shawnduong/badger/docs/README.md

# Documentation

A knowledge base for partners and developers is available publicly on [Notion](https://shawnduong.notion.site/Badger-f6cf24df8de64274823ae53d65968d2a?pvs=73).

This directory contains in-depth, technical documentation about Badger.
