shawnduong/badger/schematics/b1/b1.kicad_pcb

## KiCad design schematics/b1/b1.kicad_pcb (2024-02-21)

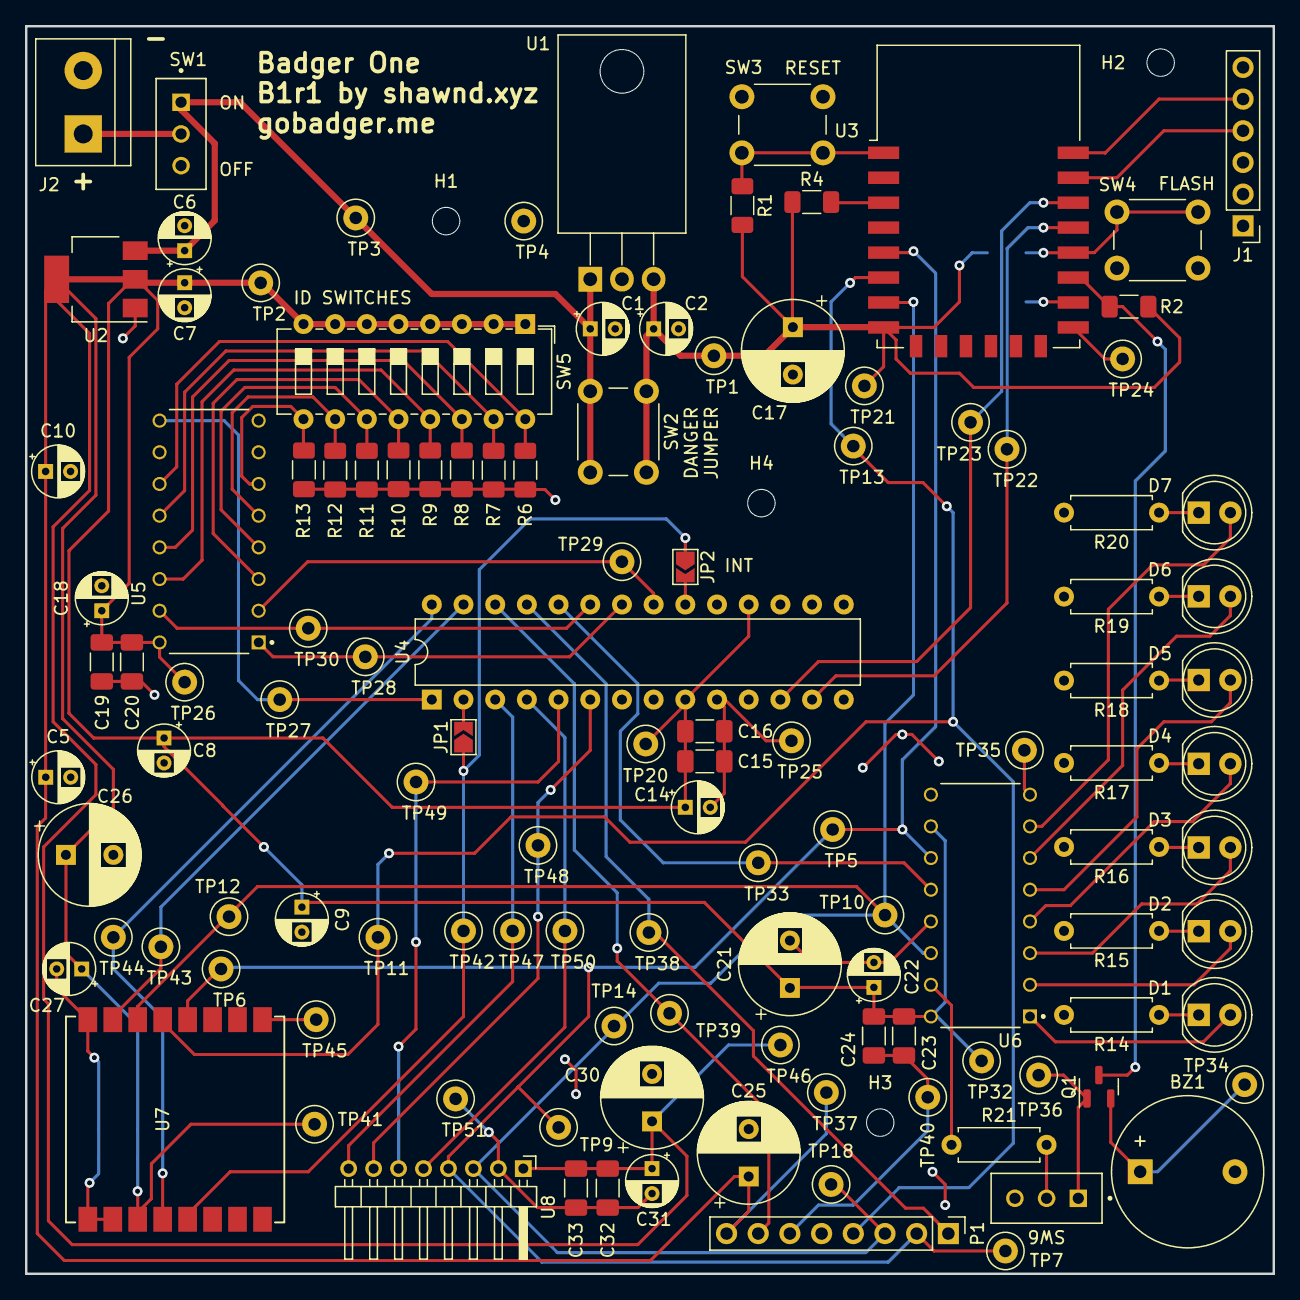
[picture p1: board b1.kicad_pcb from above]

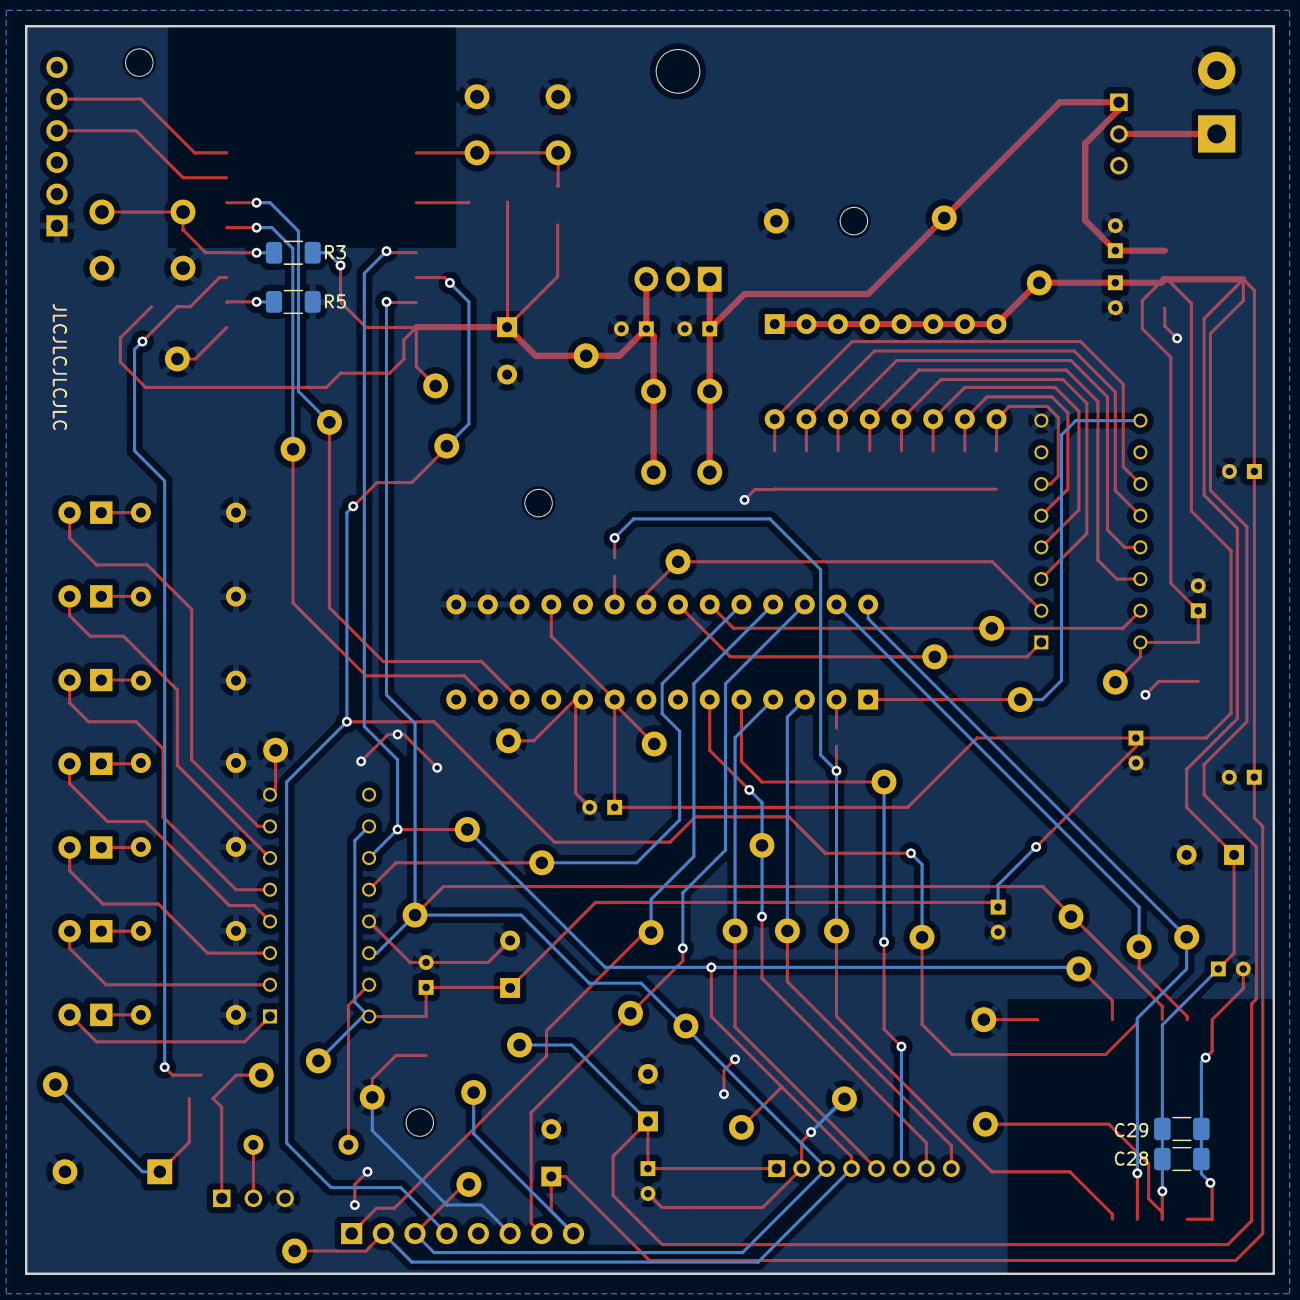
[picture p2: board b1.kicad_pcb from below]

Board: 2 copper layers, 100.0 x 100.0 mm, 126 parts (4 on the bottom side), 59 nets.

Parts:
BZ1: Buzzer; Buzzer_12x9.5RM7.6
C1, C2, C6, C7, C14, C18, C22, C27, C31: 10u; CP_Radial_D4.0mm_P2.00mm
C5, C8, C9, C10: C; CP_Radial_D4.0mm_P2.00mm
C15, C19, C23, C28, C32: 1u; C_1206_3216Metric_Pad1.33x1.80mm_HandSolder
C16, C20, C24, C29, C33: 0.1u; C_1206_3216Metric_Pad1.33x1.80mm_HandSolder
C17, C25, C26: 1m; CP_Radial_D8.0mm_P3.80mm
C21, C30: 470u; CP_Radial_D8.0mm_P3.80mm
D1: WHITE; LED_D5.0mm
D2, D7: YELLOW; LED_D5.0mm
D3: GREEN; LED_D5.0mm
D4, D6: RED; LED_D5.0mm
D5: BLUE; LED_D5.0mm
H1, H2, H3, H4: MountingHole; MountingHole_2.2mm_M2
J1: SERIAL; PinHeader_1x06_P2.54mm_Vertical
J2: POWER; TerminalBlock_bornier-2_P5.08mm
JP1, JP2: SolderJumper_2_Open; SolderJumper-2_P1.3mm_Open_TrianglePad1.0x1.5mm
P1: RFID-RC522; PinHeader_1x08_P2.54mm_Vertical
Q1: MMBT3904; SOT-23
R1, R2, R3, R4, R5, R6, R7, R8, R9, R10, R11, R12, R13: 10k; R_1206_3216Metric_Pad1.30x1.75mm_HandSolder
R14, R15, R16, R17, R18, R19, R20: 360; R_Axial_DIN0207_L6.3mm_D2.5mm_P7.62mm_Horizontal
R21: 47; R_Axial_DIN0207_L6.3mm_D2.5mm_P7.62mm_Horizontal
SW1: PWR_SW; SW_SPDT
SW2: JUMP; SW_PUSH_6mm_H4.3mm
SW3: RESET; SW_PUSH_6mm_H4.3mm
SW4: FLASH; SW_PUSH_6mm_H4.3mm
SW5: SW_DIP_x08; SW_DIP_SPSTx08_Slide_6.7x21.88mm_W7.62mm_P2.54mm_LowProfile
SW6: SW_SPDT
TP1, TP2, TP3, TP4, TP5, TP6, TP7, TP9, TP10, TP11, TP12, TP13, TP14, TP18, TP20, TP21, TP22, TP23, TP24, TP25, TP26, TP27, TP28, TP29, TP30, TP32, TP33, TP34, TP35, TP36, TP37, TP38, TP39, TP40, TP41, TP42, TP43, TP44, TP45, TP46, TP47, TP48, TP49, TP50, TP51: TestPoint; TestPoint_Loop_D2.50mm_Drill1.0mm
U1: L7805; TO-220-3_Horizontal_TabDown
U2: AMS1117-3.3; SOT-223-3_TabPin2
U3: ESP-12F; ESP-12E
U4: MCP23017_SP; DIP-28_W7.62mm
U5: 74HC165; DIP794W45P254L1969H508Q16
U6: 74HC595; DIP794W45P254L1969H508Q16
U7: Ai-Thinker-Ra-02; Ai-Thinker-Ra-01-LoRa
U8: Display; PinHeader_1x08_P2.00mm_Horizontal

Connections:
/3V3: C5.1, C7.1, C8.1, C9.1, C10.1, C14.1, C15.1, C16.1, C18.1, C19.1, C20.1, C21.1, C22.1, C23.1, C24.1, C25.1, C26.1, C27.1, C28.1, C29.1, C30.1, C31.1, C32.1, C33.1, P1.8 (3.3V), SW5.1, SW5.2, SW5.3, SW5.4, SW5.5, SW5.6, SW5.7, SW5.8, TP2.1, TP20.1, TP26.1, TP32.1, TP37.1, TP41.1, TP46.1, U2.2 (VO), U4.9 (VDD), U4.18 (~RESET), U5.16 (VCC), U6.10 (~SRCLR), U6.16 (VCC), U7.3 (VDD), U8.8 (VCC)
/5V: C2.1, C17.1, R1.2, R2.2, R3.1, R4.1, SW2.1, TP1.1, TP21.1, U1.3 (OUT), U3.8 (VCC)
/BID Register/CP: TP29.1, U4.21 (GPA0), U5.2 (CP)
/BID Register/Q7: TP27.1, U4.1 (GPB0), U5.9 (Q7)
/BID Register/~CE: TP30.1, U4.23 (GPA2), U5.15 (~CE)
/BID Register/~PL: TP28.1, U4.22 (GPA1), U5.1 (~PL)
/E-Paper/BUSY: TP47.1, U4.3 (GPB2), U8.1 (BUSY)
/E-Paper/DC: TP49.1, U4.5 (GPB4), U8.3 (DC)
/E-Paper/~CS: TP50.1, U4.4 (GPB3), U8.4 (~CS)
/E-Paper/~RST: TP48.1, U4.6 (GPB5), U8.2 (~RST)
/LoRa/DIO0: JP1.1 (A), JP2.1 (A), TP42.1, U7.5 (DIO0)
/LoRa/~NSS: TP43.1, U4.27 (GPA6), U7.15 (~NSS)
/LoRa/~RESET: TP44.1, U4.28 (GPA7), U7.4 (~RESET)
/MISO: P1.4 (MISO), TP11.1, TP13.1, U3.6 (GPIO12), U7.13 (MISO)
/MOSI: P1.3 (MOSI), TP10.1, TP12.1, TP14.1, TP18.1, U3.7 (GPIO13), U6.14 (SER), U7.14 (MOSI), U8.6 (DIN)
/SCLK: P1.2 (SCK), TP5.1, TP6.1, TP7.1, TP9.1, U3.5 (GPIO14), U6.11 (SRCLK), U7.12 (SCK), U8.5 (CLK)
/Scanner/RST: P1.7 (RST), TP39.1, U4.26 (GPA5)
/Scanner/~SS: P1.1 (SDA), TP38.1, U4.25 (GPA4)
/Status Block/BUZZ: Q1.3 (C), R2.1, U3.17 (GPIO2)
/Status Block/RCLK: TP33.1, U4.24 (GPA3), U6.12 (RCLK)
/VRAW: C1.1, C6.1, SW1.1 (A), SW2.2, TP3.1, U1.1 (IN), U2.3 (VI)
/Wi-Fi and MCU/GPB1: JP1.2 (B), U4.2 (GPB1)
/Wi-Fi and MCU/GPIO0: R3.2, SW4.2, U3.18 (GPIO0)
/Wi-Fi and MCU/GPIO15: R5.1, U3.16 (GPIO15)
/Wi-Fi and MCU/INTA: JP2.2 (B), U4.20 (INTA)
GND: BZ1.2 (-), C1.2, C2.2, C5.2, C6.2, C7.2, C8.2, C9.2, C10.2, C14.2, C15.2, C16.2, C17.2, C18.2, C19.2, C20.2, C21.2, C22.2, C23.2, C24.2, C25.2, C26.2, C27.2, C28.2, C29.2, C30.2, C31.2, C32.2, C33.2, J1.1 (GND), J2.2, P1.6 (GND), R5.2, R6.2, R7.2, R8.2, R9.2, R10.2, R11.2, R12.2, R13.2, R14.2, R15.2, R16.2, R17.2, R18.2, R19.2, R20.2, SW3.1, SW4.1, SW6.3 (C), TP4.1, TP24.1, TP25.1, TP35.1, TP40.1, TP45.1, TP51.1, U1.2 (GND), U2.1 (GND), U3.15 (GND), U4.10 (VSS), U4.15 (A0), U4.16 (A1), U4.17 (A2), U5.8 (GND), U6.8 (GND), U6.13 (~OE), U7.1 (GND), U7.2 (GND), U7.9 (GND), U7.16 (GND), U8.7 (GND)
unnamed: BZ1.1 (+), Q1.2 (E), TP34.1
unnamed: D1.2 (A), U6.1 (QB)
unnamed: D1.1 (K), R14.1
unnamed: D2.2 (A), U6.2 (QC)
unnamed: D2.1 (K), R15.1
unnamed: D3.2 (A), U6.3 (QD)
unnamed: D3.1 (K), R16.1
unnamed: D4.2 (A), U6.4 (QE)
unnamed: D4.1 (K), R17.1
unnamed: D5.2 (A), U6.5 (QF)
unnamed: D5.1 (K), R18.1
unnamed: D6.2 (A), U6.6 (QG)
unnamed: D6.1 (K), R19.1
unnamed: D7.2 (A), U6.7 (QH)
unnamed: D7.1 (K), R20.1
unnamed: J1.5 (RX), U3.22 (GPIO1/TXD)
unnamed: J1.4 (TX), U3.21 (GPIO3/RXD)
unnamed: J2.1, SW1.2 (B)
unnamed: Q1.1 (B), SW6.1 (A), TP36.1
unnamed: R21.2, SW6.2 (B)
unnamed: R4.2, U3.3 (EN)
unnamed: TP22.1, U3.19 (GPIO4), U4.13 (SDA)
unnamed: TP23.1, U3.20 (GPIO5), U4.12 (SCK)
unnamed: R1.1, SW3.2, U3.1 (~RST)
unnamed: R6.1, SW5.16, U5.11 (D0)
unnamed: R7.1, SW5.15, U5.12 (D1)
unnamed: R8.1, SW5.14, U5.13 (D2)
unnamed: R9.1, SW5.13, U5.14 (D3)
unnamed: R10.1, SW5.12, U5.3 (D4)
unnamed: R11.1, SW5.11, U5.4 (D5)
unnamed: R12.1, SW5.10, U5.5 (D6)
unnamed: R13.1, SW5.9, U5.6 (D7)
unnamed: R21.1, U6.15 (QA)
