shawnduong/badger/(threads)

Thread 2 (2024-02-13):

The ESP-12F sometimes needs a voltage jumper in order to boot properly.

shawnduong, 2024-02-13:
In very rare cases, the ESP-12F may need a voltage jumper to boot. This bug cannot be reliably replicated as of now, but the jumper capacitor pins exist as a workaround in the meanwhile.

See the note in the "Wi-Fi and MCU Secondary" schematic.

shawnduong, 2024-02-16:
Workaround implemented of just requiring a button to boost to 5V at startup. Not the most elegant solution, but it works.

Fixed in [4ecb34a](https://github.com/shawnduong/badger/commit/4ecb34afb74eaa42067f7005f9ce038c94450fef).

Closed 2024-02-16.

Thread 3 (2024-02-16):

The ISR skips the first bit.

shawnduong, 2024-02-16:
The initial state register, when using SPI, skips the first bit. This results in the reset bit always being low.

This is because the clock starts at the second value instead of the first. See the following, where the DIP switch values were 1000 0001.

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

shawnduong, 2024-02-17:
Fixed by manually shifting in instead of doing it via SPI. Fixed in [871e853](https://github.com/shawnduong/badger/commit/871e853574e59b4394ebcfdd17220e7e4686646a).

Closed 2024-02-17.
