shawnduong/badger/(commit log)

2024-01-28 Printed Unit ID at the start.
2024-02-01 Added schematic page for the initial state register.
    [b1.kicad_pcb, b1.kicad_sch, epaper.kicad_sch, initial_state.kicad_sch, lora.kicad_sch, mcu.kicad_sch, scanner.kicad_sch, status.kicad_sch]
2024-02-02 Changed GND hierarchical labels to global.
    [b1.kicad_sch, initial_state.kicad_sch]
2024-02-05 Added schematic page for the status block.
    [b1.kicad_sch, epaper.kicad_sch, initial_state_register.kicad_sch, lora.kicad_sch, mcu.kicad_sch, scanner.kicad_sch, status.kicad_sch, status_block.kicad_sch]
2024-02-05 Added status block to the index page.
    [b1.kicad_sch, status_block.kicad_sch]
2024-02-05 Added schematic page for scanner.
    [b1.kicad_sch, scanner.kicad_sch]
2024-02-06 Updated schematics.
    [initial_state_register.kicad_sch, scanner.kicad_sch, status_block.kicad_sch]
2024-02-06 Updated bypass capacitor values.
    [initial_state_register.kicad_sch, scanner.kicad_sch, status_block.kicad_sch]
2024-02-07 Added schematic page for LoRa.
    [b1.kicad_sch, epaper.kicad_sch, initial_state_register.kicad_sch, lora.kicad_sch, mcu.kicad_sch, scanner.kicad_sch, status_block.kicad_sch]
2024-02-07 Added scanner pins to the index.
    [b1.kicad_sch]
2024-02-07 Added schematic page for e-paper block.
    [b1.kicad_sch, epaper.kicad_sch, lora.kicad_sch]
2024-02-07 Updated labels.
    [b1.kicad_sch, epaper.kicad_sch, initial_state_register.kicad_sch, lora.kicad_sch, scanner.kicad_sch]
2024-02-08 General schematic updates.
    [b1.kicad_sch, epaper.kicad_sch, initial_state_register.kicad_sch, lora.kicad_sch, mcu.kicad_sch, scanner.kicad_sch, status_block.kicad_sch, wifi.kicad_sch]
2024-02-11 Consolidated DIP switches in the initial state register.
    [initial_state_register.kicad_sch]
2024-02-11 Updated status block schematic.
    [status_block.kicad_sch]
2024-02-11 Updated e-paper block schematic.
    [epaper.kicad_sch]
2024-02-11 Updated LoRa block schematic.
    [lora.kicad_sch]
2024-02-11 Updated Wi-Fi block.
    [wifi.kicad_sch]
2024-02-11 Updated scanner block.
    [scanner.kicad_sch]
2024-02-11 Updated index page.
    [b1.kicad_sch, wifi.kicad_sch]
2024-02-12 Added MCU primary schematic page.
    [b1.kicad_sch, initial_state_register.kicad_sch, mcu.kicad_sch, wifi.kicad_sch]
2024-02-13 Updated MCU and B1 schematic pages.
    [b1.kicad_sch, mcu.kicad_sch]
2024-02-13 Added notes about power for the ESP and e-paper.
2024-02-13 Added workaround for ESP-12F boot issue.
    [wifi.kicad_sch]
2024-02-13 Updated MCU and B1 schematics.
    [b1.kicad_sch, mcu.kicad_sch]
2024-02-13 Added delay to ISR for the power gating.
2024-02-13 Resorted to bitbanging the status block blinkers.
    [initial_state_register.kicad_sch, status_block.kicad_sch]
2024-02-13 Updated status block description.
    [status_block.kicad_sch]
2024-02-13 Changed status block resistor ordering for simplicity.
    [status_block.kicad_sch]
2024-02-13 Updated the status block.
    [status_block.kicad_sch]
2024-02-13 Changed tone pin.
    [mcu.kicad_sch]
2024-02-14 Updated Wi-Fi block with a jumper switch as a workaround.
    [initial_state_register.kicad_sch, scanner.kicad_sch, wifi.kicad_sch]
2024-02-14 Added instructions for the voltage jumper.
    [wifi.kicad_sch]
2024-02-14 Ported status block test section to use SPI.
2024-02-14 Ported ISR to test section to use SPI.
2024-02-16 Restructuring design back to just one MCU.
    [b1.kicad_sch]
2024-02-16 Updated Wi-Fi and MCU schematic.
    [b1.kicad_sch, wifi.kicad_sch]
2024-02-16 Updated annotations.
    [b1.kicad_sch, epaper.kicad_sch, initial_state_register.kicad_sch, lora.kicad_sch, mcu.kicad_sch, scanner.kicad_sch, status_block.kicad_sch, wifi.kicad_sch]
2024-02-16 Added an MCP23017 IC to the Wi-Fi and MCU block.
    [b1.kicad_sch, wifi.kicad_sch]
2024-02-16 Wired the ISR to the MCU.
    [b1.kicad_sch]
2024-02-16 Implemented status block test for LEDs.
2024-02-16 Implemented status block test for buzzer.
    [status_block.ino]
2024-02-16 Got rid of a potentiometer in favor of a cheaper hardcoded value.
    [b1.kicad_sch, status_block.kicad_sch]
2024-02-16 Updated tone pin name.
2024-02-16 Wired scanner to the MCU.
    [b1.kicad_sch]
2024-02-17 Removed bad connection.
    [status_block.kicad_sch]
2024-02-17 Updated buzz switch.
    [status_block.kicad_sch]
2024-02-17 Added more capacitance to the ISR.
    [initial_state_register.kicad_sch]
2024-02-17 Added diode to prevent ISR from sinking other SPI MISO signals.
    [initial_state_register.kicad_sch]
2024-02-17 Reverted back to manually shifting in the ISR.
    [initial_state_register.ino]
2024-02-17 Updated schematic to reflect manually shifting in ISR.
    [b1.kicad_sch, initial_state_register.kicad_sch]
2024-02-17 Gave the ISR its own clock to prevent SPI problems.
    [b1.kicad_sch]
2024-02-17 Added conditionals for easy switching between the fork and main MFRC522 libs.
2024-02-17 Deleted the MCU primary page.
    [b1.kicad_sch, mcu.kicad_sch]
2024-02-18 Increased bulk cap value for scanner.
    [b1.kicad_sch, scanner.kicad_sch]
2024-02-18 Redid general format and MCU wiring.
    [b1.kicad_sch, wifi.kicad_sch]
2024-02-18 Updated MCU page description.
    [wifi.kicad_sch]
2024-02-18 Cleaned up VCC ins.
    [b1.kicad_sch]
2024-02-18 Renamed the ISR to the BID Register.
    [b1.kicad_sch, bid_register.kicad_sch]
2024-02-18 Updated the BID register.
    [b1.kicad_sch, bid_register.kicad_sch]
2024-02-18 Updated RFID scanner wiring.
    [b1.kicad_sch, scanner.kicad_sch]
2024-02-18 Wired LoRa and added a bulk to the status block.
    [b1.kicad_sch, lora.kicad_sch, scanner.kicad_sch, status_block.kicad_sch, wifi.kicad_sch]
2024-02-18 Increased capacitance and added some test points.
    [b1.kicad_sch, wifi.kicad_sch]
2024-02-18 Added a bunch of test points.
    [b1.kicad_sch, bid_register.kicad_sch, lora.kicad_sch, scanner.kicad_sch, status_block.kicad_sch, wifi.kicad_sch]
2024-02-19 Added a big bulk cap to the LoRa module.
    [lora.kicad_sch]
2024-02-19 Added optional interrupt pin to MCU for LoRa module.
    [b1.kicad_sch, wifi.kicad_sch]
2024-02-19 Wired the e-paper display.
    [b1.kicad_sch, epaper.kicad_sch]
2024-02-19 Updated dates.
    [b1.kicad_sch, bid_register.kicad_sch, epaper.kicad_sch, lora.kicad_sch, scanner.kicad_sch, status_block.kicad_sch, wifi.kicad_sch]
2024-02-19 Reformatted some comments.
    [b1.kicad_sch]
2024-02-19 Tweaked wiring.
    [b1.kicad_sch, epaper.kicad_sch, status_block.kicad_sch]
2024-02-20 Stylistically shifted the SPI test points.
    [b1.kicad_sch]
2024-02-20 Modded the MCP23017 library to not set off the watchdog timer.
2024-02-20 Finalizing touches to the B1 schematic.
    [b1.kicad_sch, bid_register.kicad_sch, epaper.kicad_sch, lora.kicad_sch, scanner.kicad_sch, status_block.kicad_sch, wifi.kicad_sch]
2024-02-20 Assigned some footprints.
    [b1.kicad_pcb, b1.kicad_sch, bid_register.kicad_sch, epaper.kicad_sch, lora.kicad_sch, scanner.kicad_sch, status_block.kicad_sch, wifi.kicad_sch]
2024-02-20 Resolved all ERC messages.
    [b1.kicad_sch, epaper.kicad_sch, scanner.kicad_sch]
2024-02-20 Finished assigning footprints.
    [b1.kicad_sch, bid_register.kicad_sch, epaper.kicad_sch, lora.kicad_sch, scanner.kicad_sch, status_block.kicad_sch, wifi.kicad_sch]
2024-02-20 Added terminal block for power in.
    [b1.kicad_pcb, b1.kicad_sch]
2024-02-20 Routed some traces.
    [b1.kicad_pcb, b1.kicad_sch]
2024-02-21 Routed traces.
    [b1.kicad_pcb, b1.kicad_sch, bid_register.kicad_sch, status_block.kicad_sch]
2024-02-21 Added a ground plane to the PCB.
    [b1.kicad_pcb]
2024-02-21 Created gerber files.
    [b1-B_Cu.gbr, b1-B_Mask.gbr, b1-B_Paste.gbr, b1-B_Silkscreen.gbr, b1-Edge_Cuts.gbr, b1-F_Cu.gbr, b1-F_Mask.gbr, b1-F_Paste.gbr]
2024-02-29 Began structure for a microservice framework.
2024-03-02 Wired admin service to main.
